loeiten/Nand2Tetris-FPGA/06_Hack6-LCD/ShifterL/Readme.md

## ShifterL.v

8 bit Shiftregister used by serial peripherial interface (SPI) of modules LCD, SD and Touch.

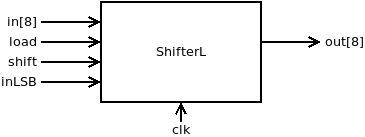
[picture p54: 06_Hack6-LCD/ShifterL/ShifterL.png]


if (load == 1) out[t+1] = in[t]

else if (shift == 1) out[t+1] = out[t] shifted one bit to left with inLSB shifted in the register as least significant bit.

### Proposed implementation
Use 8 1-Bit Registers `Bit.v` and some `Mux`.

## ShifterL_tb.v
Test bench, that loads 8 bits into the register and then shifts them to the left.

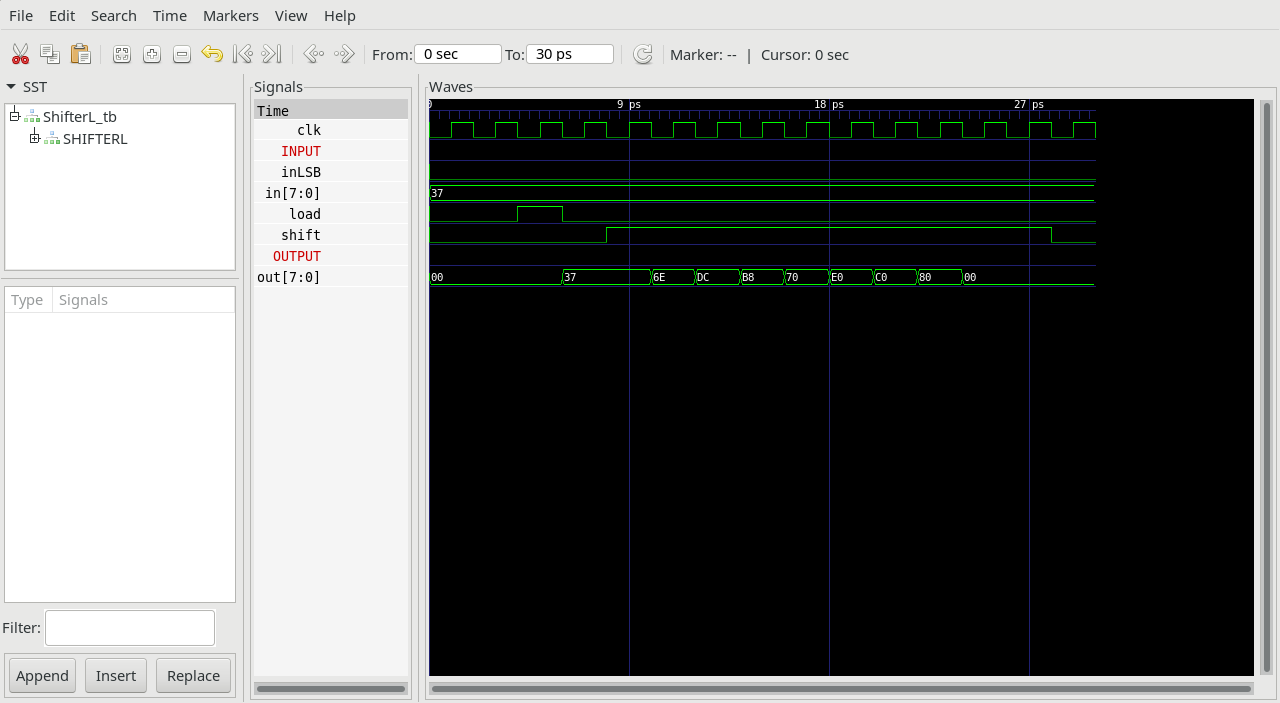
[picture p55: 06_Hack6-LCD/ShifterL/ShifterL_tb.png]

## Project
* Implement `ShiterL.v`
* Test with test bench `ShifterL_tb.v`
* Compare timing diagram with `ShifterL_tb.png`
