loeiten/Nand2Tetris-FPGA/04_Hack4-BOOT/doc/mem.png

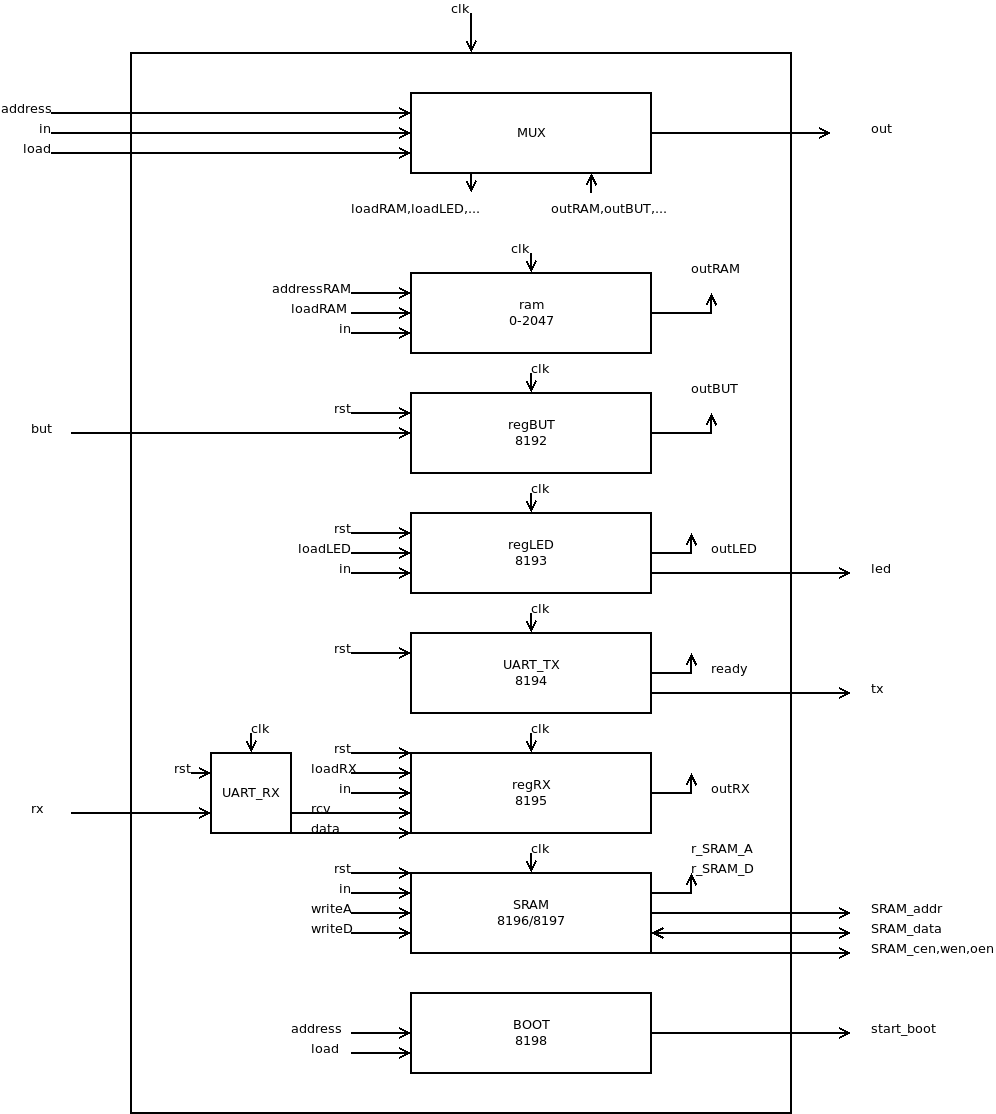
04_Hack4-BOOT/doc/mem.png
