loeiten/Nand2Tetris-FPGA/05_Jack-OS/Average/average.JPG

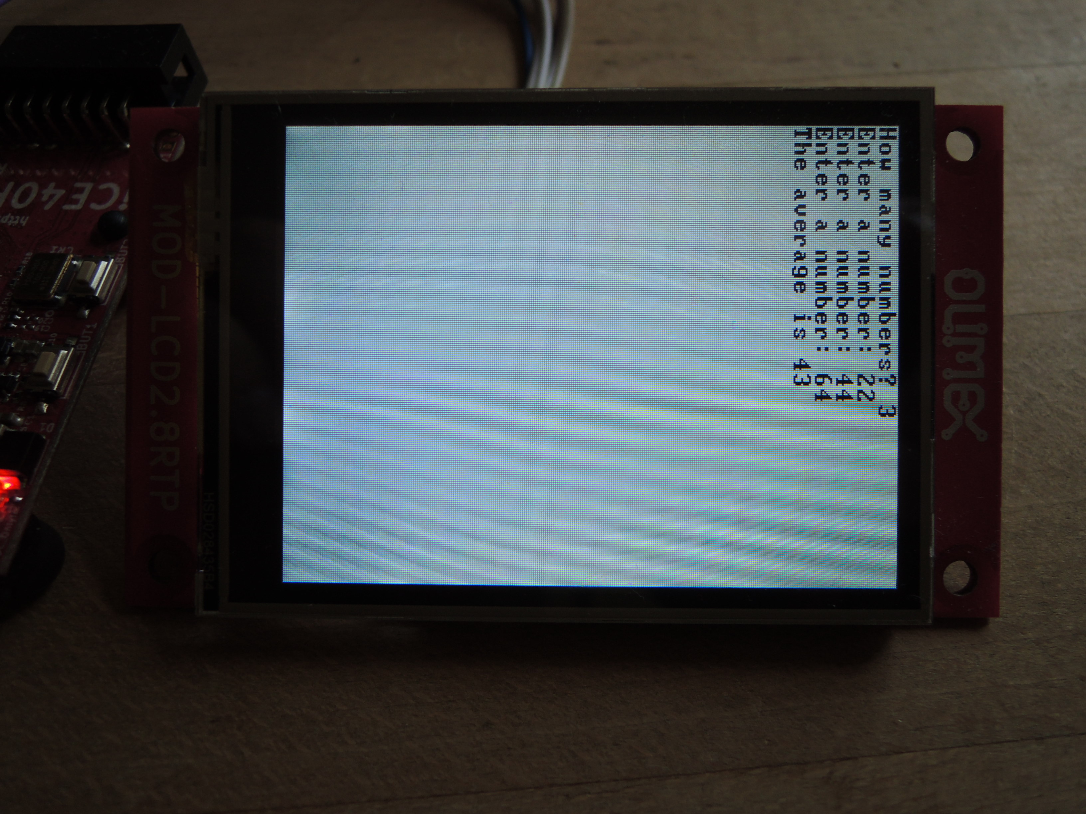
05_Jack-OS/Average/average.JPG
