loeiten/Nand2Tetris-FPGA/07_Hack7-Touch/TouchJumper.JPG

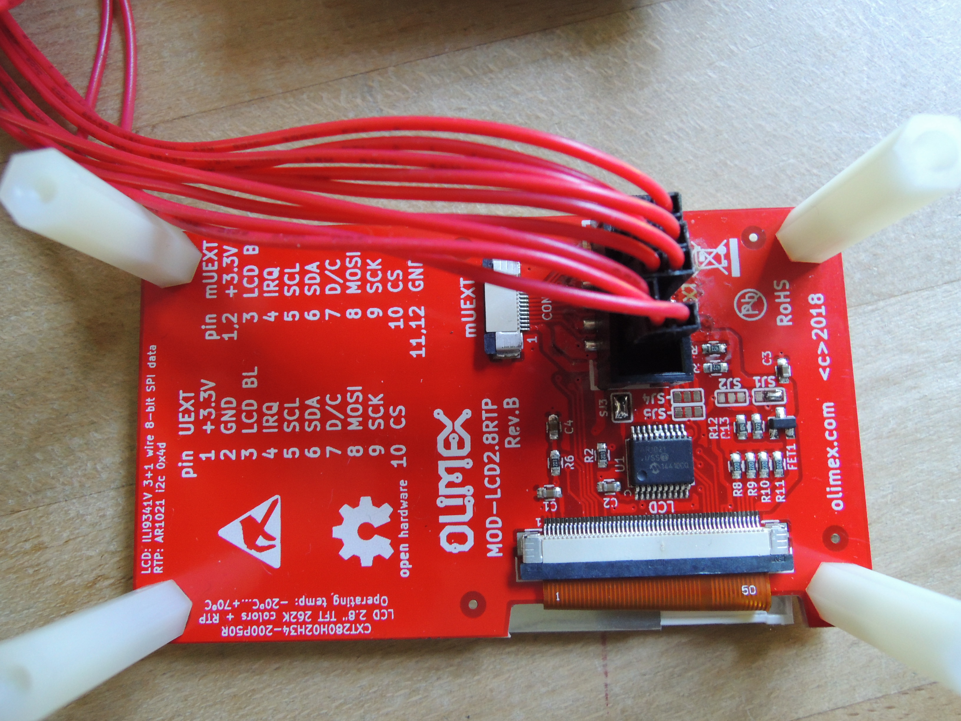
07_Hack7-Touch/TouchJumper.JPG
