loeiten/Nand2Tetris-FPGA/11_Cube/files/front-Cube.stl

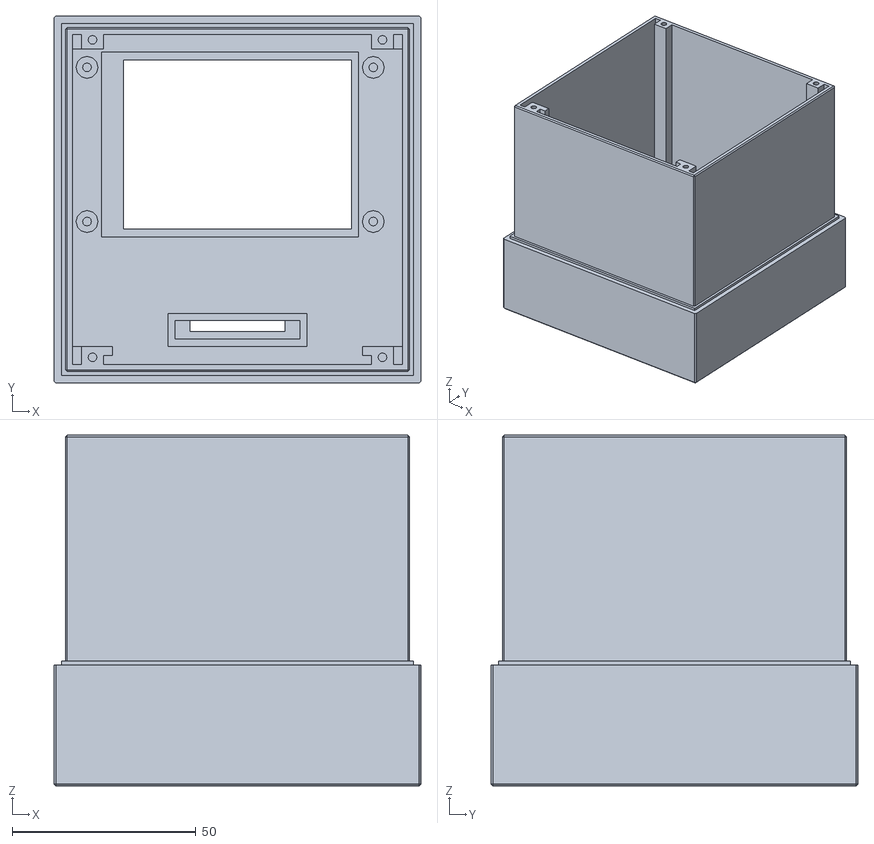
[picture p68: CAD file, 2022-08-29]
11_Cube/files/front-Cube.stl
100.0 x 100.0 x 95.6
