loeiten/Nand2Tetris-FPGA/11_Cube/files/rear_HX2K-Cube.stl

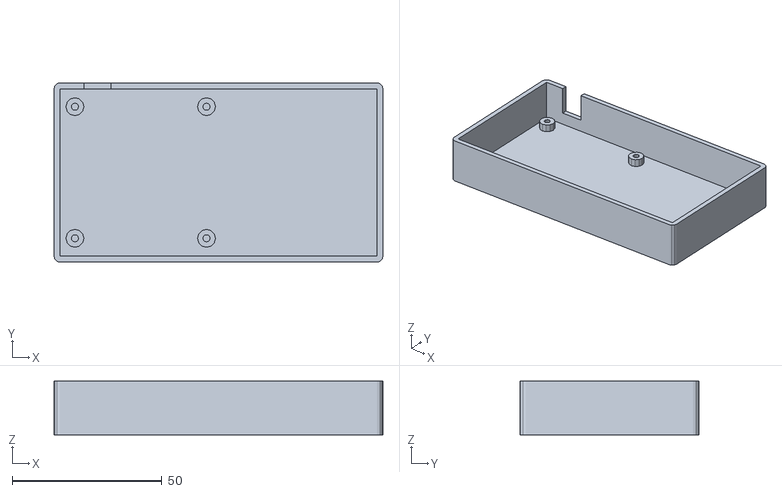
[picture p69: CAD file, 2022-08-29]
11_Cube/files/rear_HX2K-Cube.stl
110.0 x 60.0 x 18.0
