loeiten/Nand2Tetris-FPGA/11_Cube/files/front_HX2-Cube.stl

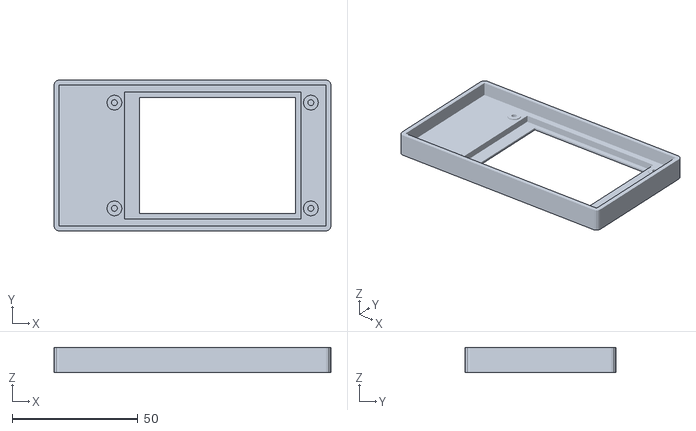
[picture p70: CAD file, 2022-08-29]
11_Cube/files/front_HX2-Cube.stl
110.0 x 60.0 x 10.00
