loeiten/Nand2Tetris-FPGA/11_Cube/files/rip-Cube.stl

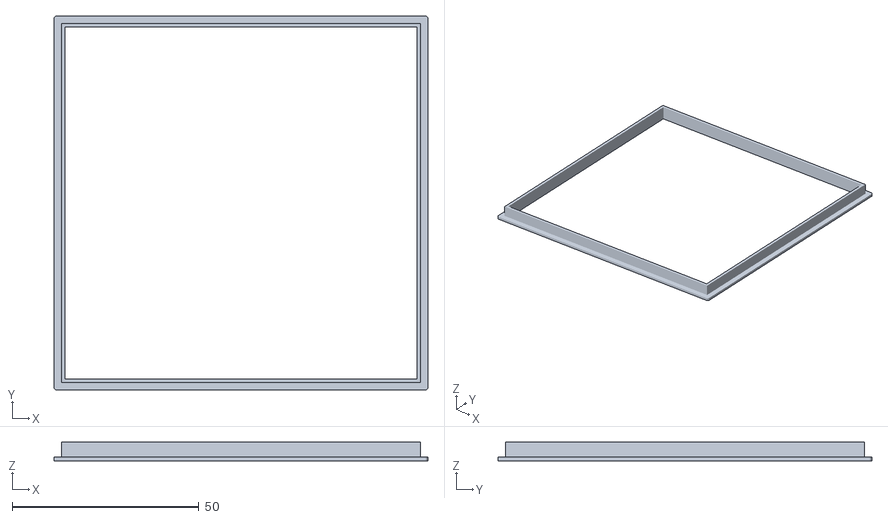
[picture p71: CAD file, 2022-08-29]
11_Cube/files/rip-Cube.stl
100.0 x 100.0 x 5.00
