loeiten/Nand2Tetris-FPGA/11_Cube/files/tray_32u4-Cube.stl

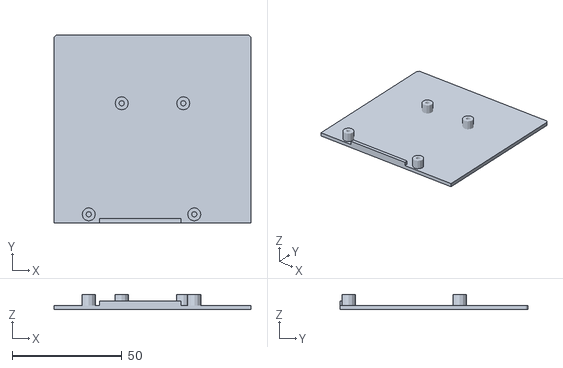
[picture p72: CAD file, 2022-08-29]
11_Cube/files/tray_32u4-Cube.stl
89.6 x 85.6 x 7.00
