loeiten/Nand2Tetris-FPGA/11_Cube/files/rear-Cube.stl

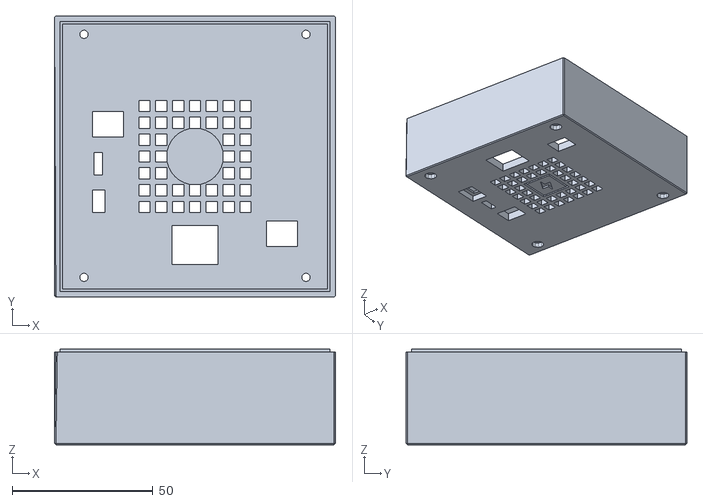
[picture p73: CAD file, 2022-08-29]
11_Cube/files/rear-Cube.stl
100.0 x 100.0 x 34.0
