loeiten/Nand2Tetris-FPGA/11_Cube/files/button-Cube.stl

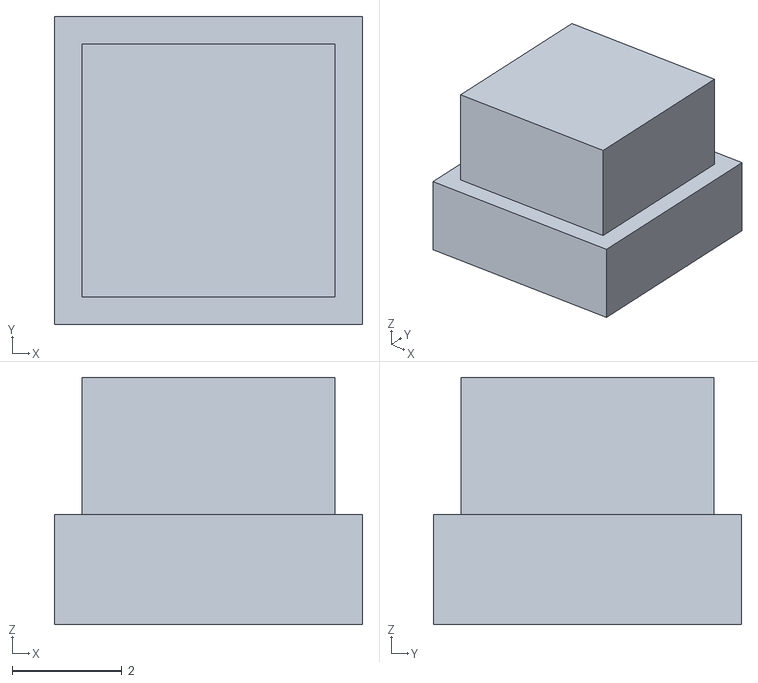
[picture p74: CAD file, 2022-08-29]
11_Cube/files/button-Cube.stl
5.60 x 5.60 x 4.50
