loeiten/Nand2Tetris-FPGA/11_Cube/files/tray_ice40_HX1K-Cube.stl

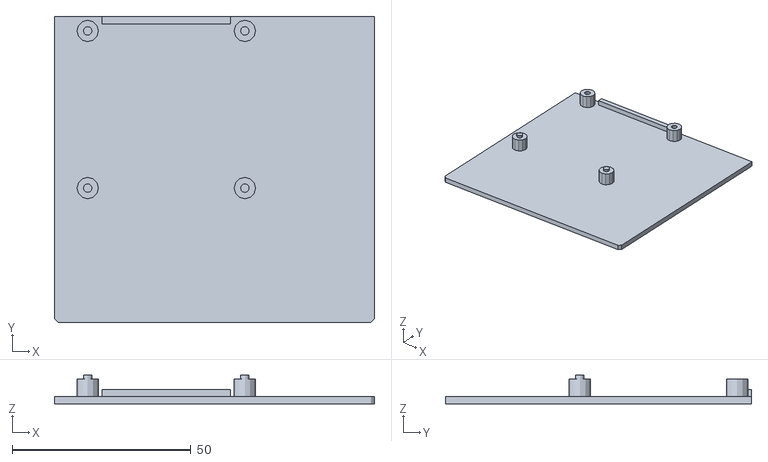
[picture p75: CAD file, 2022-08-29]
11_Cube/files/tray_ice40_HX1K-Cube.stl
89.6 x 85.6 x 8.00
