loeiten/Nand2Tetris-FPGA/11_Cube/files/rip_center-Cube.stl

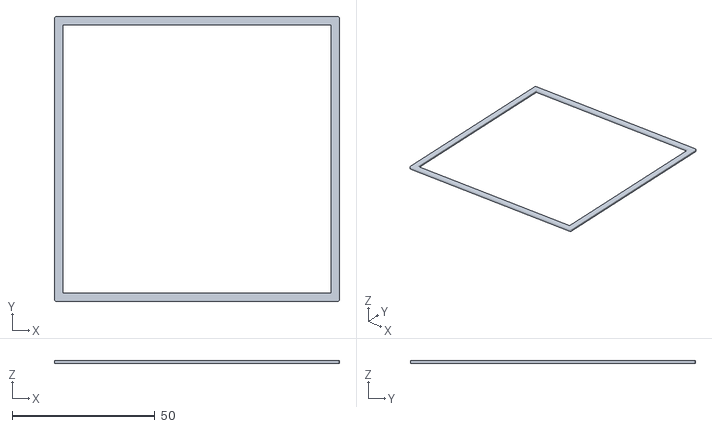
[picture p76: CAD file, 2022-08-29]
11_Cube/files/rip_center-Cube.stl
100.0 x 100.0 x 1.00
