loeiten/Nand2Tetris-FPGA/11_Cube/files/tray_SD_ETH-Cube.stl

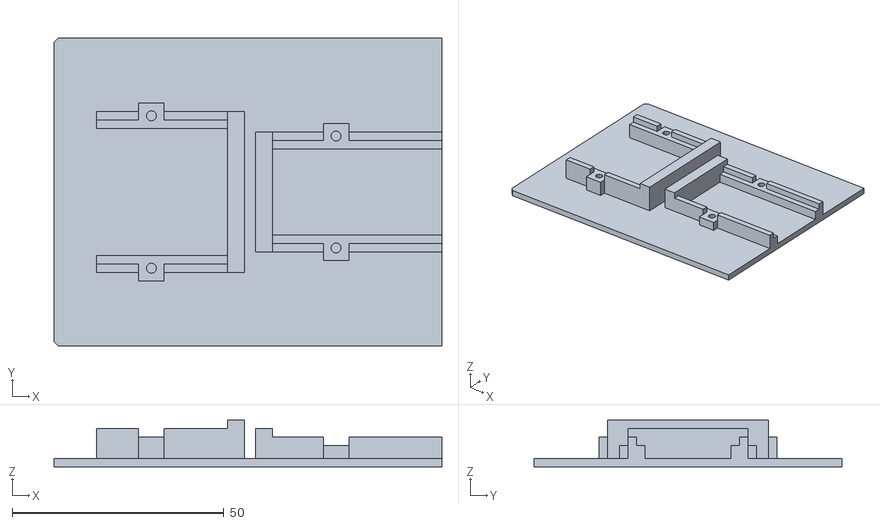
[picture p77: CAD file, 2022-08-29]
11_Cube/files/tray_SD_ETH-Cube.stl
91.6 x 72.6 x 11.0
