loeiten/Nand2Tetris-FPGA/(list of files, cad)

Other CAD files:
11_Cube/files/rear_HX1K-Cube.stl
11_Cube/files/tray_ice40-Cube.stl
11_Cube/files/button.blend
11_Cube/files/cube.blend
11_Cube/files/front.blend
11_Cube/files/front_HX1.blend
11_Cube/files/front_HX2.blend
11_Cube/files/nothing.blend
11_Cube/files/rear.blend
11_Cube/files/rear_HX1K.blend
11_Cube/files/rear_HX2K.blend
11_Cube/files/rear_button_led.blend
11_Cube/files/rip.blend
11_Cube/files/rip_center.blend
11_Cube/files/tray_32u4.blend
11_Cube/files/tray_SD_ETH.blend
11_Cube/files/tray_ice40.blend
11_Cube/files/tray_ice40_HX1K.blend
