loeiten/Nand2Tetris-FPGA/Makefiles/README.md

# Makefiles

This directory contains `Makefiles` which are symlinked throughout the repository.
