loeiten/Nand2Tetris-FPGA/06_Hack6-LCD/jack/ScreenTest/screen.jpg

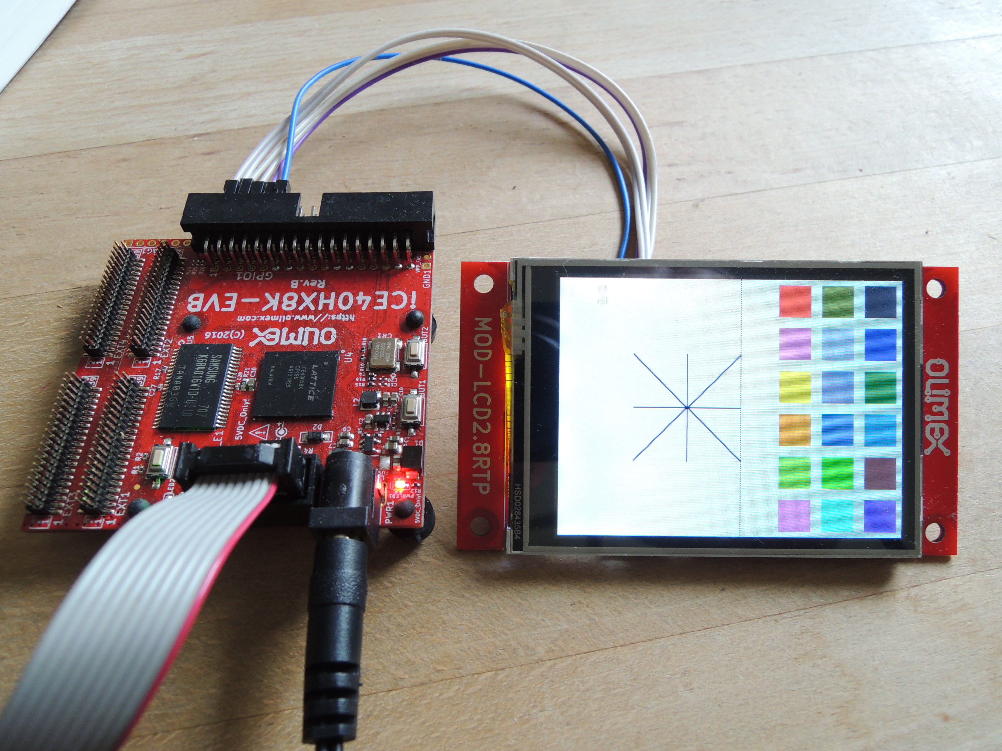
06_Hack6-LCD/jack/ScreenTest/screen.jpg
