loeiten/Nand2Tetris-FPGA/10_Hack10-Network/Hack10_HX8/Hack10.pcf

# physical constrain file
# assign io-pins to pin numbering of iCE40-HX1K on Olimex board iCE40-HX1K-EVB
# compare to the schematic of the board and the datasheet of FPGA
# to use internal pullup set (-pullup yes)

set_io clk_in J3
set_io but[0] K11 # BUT1 on board
set_io but[1] P13 # BUT2 on board
set_io but[2] J4 # GPIO 20
set_io but[3] H2 # GPIO 18
set_io but[4] J5 # GPIO 16
set_io but[5] G1 # GPIO 14
set_io but[6] H1 # GPIO 12
set_io but[7] J2 # GPIO 10

set_io led[0] M12 # LED1 on board
set_io led[1] R16 # LED2 on board
set_io led[2] H3 # GPIO 32
set_io led[3] F2 # GPIO 30
set_io led[4] H6 # GPIO 28
set_io led[5] F1 # GPIO 26
set_io led[6] H4 # GPIO 24
set_io led[7] G2 # GPIO 22

set_io rx L11	# UEXT
set_io tx T16	# UEXT

set_io sram_addr[0] N6
set_io sram_addr[1] T1
set_io sram_addr[2] P4
set_io sram_addr[3] R2
set_io sram_addr[4] N5
set_io sram_addr[5] T2
set_io sram_addr[6] P5
set_io sram_addr[7] R3
set_io sram_addr[8] R5
set_io sram_addr[9] T3
set_io sram_addr[10] R4
set_io sram_addr[11] M7
set_io sram_addr[12] N7
set_io sram_addr[13] P6
set_io sram_addr[14] M8
set_io sram_addr[15] T5
set_io sram_addr[16] R6
set_io sram_addr[17] P8

set_io sram_cen T6
set_io sram_oen L9
set_io sram_wen T7

set_io sram_data[0] T8
set_io sram_data[1] P7
set_io sram_data[2] N9
set_io sram_data[3] T9
set_io sram_data[4] M9
set_io sram_data[5] R9
set_io sram_data[6] K9
set_io sram_data[7] P9
set_io sram_data[8] R10
set_io sram_data[9] L10
set_io sram_data[10] P10
set_io sram_data[11] N10
set_io sram_data[12] T10
set_io sram_data[13] T11
set_io sram_data[14] T15
set_io sram_data[15] T14

set_io lcd_dcn E4
set_io lcd_mosi B2
set_io lcd_sck F5
set_io lcd_cen B1

set_io tp_miso C1
set_io tp_mosi C2
set_io tp_sck F4

set_io snd D2

set_io sd_miso G5
set_io sd_mosi D1
set_io sd_sck G4
set_io sd_cen E3

set_io eth_miso H5
set_io eth_mosi E2
set_io eth_sck G3
set_io eth_cs F3
