loeiten/Nand2Tetris-FPGA/05_Jack-OS/Average/out.asm

@256
D=A
@SP
M=D
@0
D=A
@R14
M=D
@Sys.init
D=A
@R13
M=D
@return0
D=A
@CALL
0;JMP
(return0)
(HALT)
@HALT
0;JMP
(RETURN)
@LCL
D=M
@R13
M=D
@R13
D=M
@5
A=D-A
D=M
@R14
M=D
@SP
A=M-1
D=M
@ARG
A=M
M=D
@ARG
D=M+1
@SP
M=D
@R13
AM=M-1
D=M
@THAT
M=D
@R13
AM=M-1
D=M
@THIS
M=D
@R13
AM=M-1
D=M
@ARG
M=D
@R13
AM=M-1
D=M
@LCL
M=D
@R14
A=M
0;JMP
(CALL)
@SP
A=M
M=D
@SP
M=M+1
@LCL
D=M
@SP
A=M
M=D
@SP
M=M+1
@ARG
D=M
@SP
A=M
M=D
@SP
M=M+1
@THIS
D=M
@SP
A=M
M=D
@SP
M=M+1
@THAT
D=M
@SP
A=M
M=D
@SP
M=M+1
@SP
D=M
@5
D=D-A
@R14
A=M
D=D-A
@ARG
M=D
@SP
D=M
@LCL
M=D
@R13
A=M
0;JMP

(Memory.init)
@0
D=A
(Memory.init_LOOP)
@Memory.init_END
D;JEQ
@SP
A=M
M=0
@SP
M=M+1
D=D-1
@Memory.init_LOOP
0;JMP
(Memory.init_END)

@0  //push constant
D=A
@SP
A=M
M=D
@SP
M=M+1
@SP  //pop static
AM=M-1
D=M
@Memory.0
M=D
@1024  //push constant
D=A
@SP
A=M
M=D
@SP
M=M+1
@Memory.0   //push static
D=M
@SP
A=M
M=D
@SP
M=M+1
@SP  //add
AM=M-1
D=M
A=A-1
M=D+M
@2816  //push constant
D=A
@SP
A=M
M=D
@SP
M=M+1
@SP  //pop temp
AM=M-1
D=M
@R5
M=D
@SP  //pop pointer
AM=M-1
D=M
@THAT
M=D
@R5 //push temp
D=M
@SP
A=M
M=D
@SP
M=M+1
@THAT    //pop that
D=M
@0
D=D+A
@R13
M=D
@SP
AM=M-1
D=M
@R13
A=M
M=D
@1025  //push constant
D=A
@SP
A=M
M=D
@SP
M=M+1
@Memory.0   //push static
D=M
@SP
A=M
M=D
@SP
M=M+1
@SP  //add
AM=M-1
D=M
A=A-1
M=D+M
@1026  //push constant
D=A
@SP
A=M
M=D
@SP
M=M+1
@SP  //pop temp
AM=M-1
D=M
@R5
M=D
@SP  //pop pointer
AM=M-1
D=M
@THAT
M=D
@R5 //push temp
D=M
@SP
A=M
M=D
@SP
M=M+1
@THAT    //pop that
D=M
@0
D=D+A
@R13
M=D
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
D=M
@0
D=D+A
@R13
M=D
@SP
AM=M-1
D=M
@R13
A=M
M=D
@Math.sqrt$while5
0;JMP
(Math.sqrt$whileend5)
@LCL //push local
D=M
@1
A=D+A
D=M
@SP
A=M
M=D
@SP
M=M+1
@RETURN
0;JMP

(Math.max)
@0
D=A
(Math.max_LOOP)
@Math.max_END
D;JEQ
@SP
A=M
M=0
@SP
M=M+1
D=D-1
@Math.max_LOOP
0;JMP
(Math.max_END)

@ARG //push argument
D=M
@0
A=D+A
D=M
@SP
A=M
M=D
@SP
M=M+1
@Math.0   //push static
D=M
@SP
A=M
M=D
@SP
M=M+1
@SP
AM=M-1
D=M
A=A-1
D=M-D
M=-1
@gt50
D;JGT
@SP
A=M-1
M=0
(gt50)
@SP
AM=M-1
D=M
@Math.max$if1
D;JNE
@Math.max$ifelse1
0;JMP
(Math.max$if1)
@ARG //push argument
D=M
@0
A=D+A
D=M
@SP
A=M
M=D
@SP
M=M+1
@RETURN
0;JMP

(Math.max$ifelse1)
@Math.0   //push static
D=M
@SP
A=M
M=D
@SP
M=M+1
@RETURN
0;JMP

(Math.min)
@0
D=A
(Math.min_LOOP)
@Math.min_END
D;JEQ
@SP
A=M
M=0
@SP
M=M+1
D=D-1
@Math.min_LOOP
0;JMP
(Math.min_END)

@ARG //push argument
D=M
@0
A=D+A
D=M
@SP
A=M
M=D
@SP
M=M+1
@Math.0   //push static
D=M
@SP
A=M
M=D
@SP
M=M+1
@SP
AM=M-1
D=M
A=A-1
D=M-D
M=-1
@lt51
D;JLT
@SP
A=M-1
M=0
(lt51)
@SP
AM=M-1
D=M
@Math.min$if1
D;JNE
@Math.min$ifelse1
0;JMP
(Math.min$if1)
@ARG //push argument
D=M
@0
A=D+A
D=M
@SP
A=M
M=D
@SP
M=M+1
@RETURN
0;JMP

(Math.min$ifelse1)
@Math.0   //push static
D=M
@SP
A=M
M=D
@SP
M=M+1
@RETURN
0;JMP
