loeiten/Nand2Tetris-FPGA/Hack_chip/And16.v

/**
 * 16-bit bitwise And:
 * for i = 0..15: out[i] = (a[i] and b[i])
 */

`default_nettype none
module And16(
    input wire [15:0] a,
    input wire [15:0] b,
    output wire [15:0] out
  );

  // Translation of And16.hdl
  And And0(.a(a[0]), .b(b[0]), .out(out[0]));
  And And1(.a(a[1]), .b(b[1]), .out(out[1]));
  And And2(.a(a[2]), .b(b[2]), .out(out[2]));
  And And3(.a(a[3]), .b(b[3]), .out(out[3]));
  And And4(.a(a[4]), .b(b[4]), .out(out[4]));
  And And5(.a(a[5]), .b(b[5]), .out(out[5]));
  And And6(.a(a[6]), .b(b[6]), .out(out[6]));
  And And7(.a(a[7]), .b(b[7]), .out(out[7]));
  And And8(.a(a[8]), .b(b[8]), .out(out[8]));
  And And9(.a(a[9]), .b(b[9]), .out(out[9]));
  And And10(.a(a[10]), .b(b[10]), .out(out[10]));
  And And11(.a(a[11]), .b(b[11]), .out(out[11]));
  And And12(.a(a[12]), .b(b[12]), .out(out[12]));
  And And13(.a(a[13]), .b(b[13]), .out(out[13]));
  And And14(.a(a[14]), .b(b[14]), .out(out[14]));
  And And15(.a(a[15]), .b(b[15]), .out(out[15]));

endmodule
