loeiten/Nand2Tetris-FPGA/06_Hack6-LCD/LCD/Include.v

`include "../../Hack/Nand.v"
`include "../../Hack/Not.v"
`include "../../Hack/And.v"
`include "../../Hack/Or.v"

`include "../../Hack/Xor.v"
`include "../../Hack/Mux.v"
`include "../../Hack/Mux16.v"
`include "../../Hack/Not16.v"
`include "../../Hack/HalfAdder.v"
`include "../../Hack/FullAdder.v"
`include "../../Hack/Add16.v"
`include "../../Hack/And16.v"
`include "../../Hack/Or8Way.v"

`include "../../Hack/DMux.v"
`include "../../Hack/DMux4Way.v"
`include "../../Hack/DMux8Way.v"

`include "../../Hack/Inc16.v"
`include "../../Hack/DFF.v"
`include "../../Hack/Bit.v"
`include "../../Hack/Register.v"

`include "../../Hack/ALU.v"
`include "../../Hack/PC.v"

`include "../../Hack/Clock.v"
`include "../../Hack/CPU.v"
`include "../../Hack/Memory.v"

`include "../../Hack/Switch.v"
`include "../../Hack/ShifterR.v"
`include "../../Hack/ShifterL.v"

`include "../../Hack/UartTX.v"
`include "../../Hack/UartRX.v"


`include "../../Hack/Tristate.v"
